eYSIP-2018/Low_Cost_Sensor_Node/FINAL_CODES/ATMEL_CODES/Readme.txt

Main final working codes are
1.RFreceiver
2.RFTRANS_1
In RFTRANS_1 just change the node number for increasing number of nodes
3.uartreceiver
Simple testing of  only uart
