eYSIP-2018/Low_Cost_Sensor_Node/FINAL_CODES/ARDUINO_CODES/Readme.txt

This folder contains all the testing codes on arduino-pro-mini.
