eYSIP-2018/Low_Cost_Sensor_Node/FINAL_CODES/ARDUINO_CODES/NRF24L01/Readme.txt

This file contains two code for basic testing of NRF24L01+ proper communication.
Also this Codes can be used for prototype tesing in outdoor enviornment.
