eYSIP-2018/Low_Cost_Sensor_Node/Documentation/Code Documentation/main.pdf

# NRF Based Sensor Node - Code Documentation

## Sachin Jadhav

## August 5, 2018

# 1 Introduction

### This Code Documenatation contains Documentation of three libraries

### 1. GPIO

### 2. SPI

3. RF24

# 2 Code Description

### - GPIO.cpp

### 1. void Set Pin (unsigned int num, unsigned int dir ) To set a particular pin as input (IN) or output (OUT) .e.g Set pin(13,OUT)

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

### 2. void Write Digital (unsigned char , unsigned char )

To set a particular output pin as a high or low by giving pin number and value. e.g. Write Digital(13,high);

1

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

### 3. void mosfet on() Turn on mosfet which is connected on D8 pin . Which gives supply voltage to NRF and ADC channels

void m o s f e t o n ( )
{
DDRB |= 0 x01 ; // m o s fe t D8 p in
PORTB |= 0 x00 ; // w r i t e 0 t o ON P c h annel MOSFET }

### 4. void mosfet off() Turn off mosfet which is connected on D8 pin . Which turn off the supply voltage to NRF and ADC channels

void m o s f e t o f f ( )
{

PORTB &= 0xFE ; // w r i t e 1 t o OFF P c h annel MOSFET }

### 5. void UART Init(); //initilzation of uart To initialize a UART for serial Communication with default 9600 baud rate

void UART Init ( )
{
UCSR0B = 0 x00 ;
UCSR0A = 0 x00 ;
UCSR0C|= (1<<UCSZ1) | (1<<UCSZ0)|(1<< USBS0 ) ;
// Asynchronous mode 8− b i t da ta and 1−s t o p b i t
// UBRR0L = 103 ;// 16MHZ f o r 9600 bps
UBRR0L = 5 1;
// 8MHZ C r y s t a l s e t baud r a t e 9 6 0 0 ( 5 1 ) , 4 8 0 0 ( 1 0 3 ) , 2 4 0 0 ( 2 0 6 )
fo r s e r i a l t r a n smi s si o n with e x t e r n a l c r y s t a l o s c i l a t o r a t 8. 0 MHz UBRR0H = 0 ;
UCSR0B |= (1<<RXEN) | (1<<TXEN) ; // Enable R e c e i p t i o n and Transm iss ion
}

2

6. char UART Read();

### This function checks for any data available on Rx bufer of Atmega328p And if availble

Reads 8 bit data in Rxbuffer and returns in char type data.

// //// t o read one b y t e
char UART Read ( )
{
while ( ! ( UCSR0A & (1<<RXC0 ) ) ) ; /∗ Wait u n t i l d a t a e x i s t s . ∗/ // l o o p u n t i l b i t i s s e t (UCSR0A, RXC0) ;
return UDR0;
}
7. void UART Transmit(unsigned char data );

### Transmitts single unsigned char data through UART

void UART Transmit (unsigned char data )
{
UCSR0A = 1<<TXC0;
/∗ Wait f o r empty t r a n sm i t b u f f e r ∗/
while ( ! ( UCSR0A & (1<<UDRE0) ) ) ;
/∗ Put da ta i n t o b u f f e r , sen d s t h e d a t a ∗/
UDR0 = data ;
while ( ! ( UCSR0A & (1<<TXC0 ) ) ) ; // w a i t f o r t a r n sm i s s i o n t o c om ple te }

### 8. void UART Printf(const char *text)

Sends String to serial i.e. to print a string on serial monitor without a newline character

void UART Printf ( const char ∗ t e x t )
{
unsigned char i =0;
while ( ! ( ∗ ( t e x t+i ) == ’ \0 ’ ) )
{
UART Transmit ( ∗ ( t e x t+i ) ) ; i ++;
}
}

### 9. void UART Printfln(const char *text) Sends String to serial i.e. to print a string on serial monitor with new line

void UART Printfln ( const char ∗ t e x t )
{
unsigned char i =0;
while ( ! ( ∗ ( t e x t+i ) == ’ \0 ’ ) )
{
UART Transmit ( ∗ ( t e x t+i ) ) ; i ++;
}
UART Transmit ( ’ \n ’ ) ;
}

### 10. void UART Print Num(unsigned int n) To print unsigned int number on serial monitor

/// t o p r i n t un s igne d i n t number
void UART Print Num (unsigned int n )
{
unsigned char ch=0;
ch= n/10000+0 x30 ;

3

i f ( ! ( ch==0x30 ) )
UART Transmit ( ch ) ;
n=n%10000;
ch=n/1000+0 x30 ;
i f ( ! ( ch==0x30 ) )
UART Transmit ( ch ) ;
n=n%1000;
ch=n/100+0 x30 ;
i f ( ! ( ch==0x30 ) )
UART Transmit ( ch ) ;
n=n%100;
ch=n/10+0x30 ;
i f ( ! ( ch==0x30 ) )
UART Transmit ( ch ) ;
ch=(n%10)+0x30 ;
UART Transmit ( ch ) ;
UART Transmit ( ’ \n ’ ) ;
}

### 11. void UART Print Numchar(unsigned char n) To print unsigned char number on serial monitor

/// t o p r i n t un s igne d char number
void UART Print Numchar (unsigned char n ) {
unsigned char ch=0;
ch=n/100+0 x30 ;
UART Transmit ( ch ) ;
n=n%100;
ch=n/10+0x30 ;
UART Transmit ( ch ) ;
ch=(n%10)+0x30 ;
UART Transmit ( ch ) ;
UART Transmit ( ’ \n ’ ) ; }
12. void timer0 init ();

### TIMER 0 is 8 bit timer Timer0 is used in CTC mode for delay function which creates delay of 1 millisecond using TIMERO ISR

// // t imer0 in CTC mode w i t h i n t e r r u p t
void t i m e r 0 i n i t ( )
{
// s e t t imer0 i n t e r r u p t a t 1kHz TCCR0A = 0 ;
TCCR0B = 0 ;
TCNT0 = 0 ;
// s e t compare match r e g i s t e r f o r 1 khz incremen t s
OCR0A = 1 2 4; // = (8∗10ˆ6) / (1000∗64) − 1 ( must be <256) // turn on CTC mode
TCCR0A |= ( 1 << WGM01) ;
// Se t CS01 and CS00 b i t s f o r 64 p r e s c a l e r
TCCR0B |= ( 1 << CS01 ) | ( 1 << CS00 ) ;
// e n a bl e t ime r compare i n t e r r u p t
TIMSK0 |= ( 1 << OCIE0A ) ;
}

### 13. ISR(TIMER0 COMPA vect)

4

### This is Interrupt Sub routine for TIMER 0 interrupt which updates global cnt variable

for getting current millis value in the running program.

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

### 14. unsigned int millis() This function gives current execution time of a program in millisecond

Returns a Integar variable in between 0 to 65535.

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

15. void power down (unsigned int s time) API function for setting u-controller in deep sleep mode for given time in minutes This function puts MCU in Power down mode i.e External Crystal is off , along with for reducing power consumption it Disables Brounout Detection , Disables digital input buffers on ADC pins The MCU is configured so as to wake up after predefined timeout using Watchdog timer . Which uses internal 128KHz crystal

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

5

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

### 16. ISR(WDT vect) This is Interrupt Subroutine for Watchdog timer which do nothing .Just used for Extend-

ing sleep timeout.

// ISR For WATCHDOG TIMER
ISR (WDT vect )
{

} ;

### 17. unsigned int adcinit(int channel) This function do the Initialization of ADC and returns ADC conversion result

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

### 18. uint8 t get batt voltage()

This Function reads the ADC channel number 5 .

### On channel number 5 battery voltage is connected . Returns the single byte result of

battery voltage.

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

### 19. uint8 t get temp(int ch) This Function reads the ADC channel number specified on which temperature sensor is

6

connected.

### Returns single byte result temperature value

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

### 20. uint8 t get soil moisture() This Function reads the ADC channel number 0 on which default soil moisture sensor is

connected.

### Returns single byte result of moisture content percentage value

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

### 21. void getdata()

Function to collect all sensors data for transmission.

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

### - SPI library This library has two files SPI.h and SPI.cpp

In SPI.h clas SPIClass is defined with its all methods.
In SPI.cpp it has API’s related initilsation of SPI for connected module.

### 1. SPI.h

7

#i fnd e f SPI H INCLUDED

#def ine | SPI H INCLUDED

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

8

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

### 2. SPI.cpp

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

SPCR |= BV (MSTR) ; // s e l e c t s mas ter mode
SPCR |= BV (SPE ) ; // En able s SPI communiation

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

### RF24 library contains 4 files

### – RF24config.h – nRF24L01.h – RF24.h – RF24.cpp

### (a) RF24config.h This file includes necessary header files for RF24.h and also defines some macros to

use in RF24.h file.

#i fnd e f | RF24 CONFIG H

#def ine | RF24 CONFIG H

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

#d e f i n e r f 2 4 mi n ( a , b ) ( a<b? a : b )

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

9

#e n d i f

#i n cl u d e ”SPI . h”

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

#i n cl u d e <s t d i o . h>

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

#d e f i n e BV ( x ) (1<<(x ) )

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

#d e f i n e p r i n t f P p r i n t f

#d e f i n e s t r l e n P s t r l e n

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

#d e f i n e PRIPSTR ”%s ”

#end if // RF24 CONFIG H

### (b) nRF24L01.h

This header file has declaration of macros for all registers in NRF24L01+ .

/∗ Memory Map ∗/
#def ine NRF CONFIG | 0 x00

#def ine EN AA | 0 x01

#def ine EN RXADDR | 0 x02

#def ine SETUP AW | 0 x03

#def ine SETUP RETR | 0 x04

#def ine RF CH | 0 x05

#def ine RF SETUP | 0 x06

#def ine NRF STATUS | 0 x07

#def ine OBSERVE TX | 0 x08

#def ine CD | 0 x09

#def ine RX ADDR P0 | 0x0A

#def ine RX ADDR P1 | 0x0B

#def ine RX ADDR P2 | 0x0C

#def ine RX ADDR P3 | 0x0D

#def ine RX ADDR P4 | 0x0E

#def ine RX ADDR P5 | 0x0F

#def ine TX ADDR | 0 x10

#def ine RX PW P0 | 0 x11

#def ine RX PW P1 | 0 x12

#def ine RX PW P2 | 0 x13

#def ine RX PW P3 | 0 x14

#def ine RX PW P4 | 0 x15

#def ine RX PW P5 | 0 x16

#def ine FIFO STATUS 0 x17

#def ine DYNPD | 0x1C

#def ine FEATURE | 0x1D

/∗ B i t Mnemonics ∗/
#def ine MASK RX DR | 6

#def ine MASK TX DS | 5

#def ine MASK MAX RT 4

#def ine EN CRC | 3

#def ine CRCO | 2

#def ine PWR UP | 1

#def ine PRIM RX | 0

#def ine ENAA P5 | 5

#def ine ENAA P4 | 4

10

#def ine ENAA P3 | 3

#def ine ENAA P2 | 2

#def ine ENAA P1 | 1

#def ine ENAA P0 | 0

#def ine ERX P5 | 5

#def ine ERX P4 | 4

#def ine ERX P3 | 3

#def ine ERX P2 | 2

#def ine ERX P1 | 1

#def ine ERX P0 | 0

#def ine AW | 0

#def ine ARD | 4

#def ine ARC | 0

#def ine PLL LOCK | 4

#def ine RF DR | 3

#def ine RF PWR | 6

#def ine RX DR | 6

#def ine TX DS | 5

#def ine MAX RT | 4

#def ine RX P NO | 1

#def ine TX FULL | 0

#def ine PLOS CNT | 4

#def ine ARC CNT | 0

#def ine TX REUSE | 6

#def ine FIFO FULL | 5

#def ine TX EMPTY | 4

#def ine RX FULL | 1

#def ine RX EMPTY | 0

#def ine DPL P5 | 5

#def ine DPL P4 | 4

#def ine DPL P3 | 3

#def ine DPL P2 | 2

#def ine DPL P1 | 1

#def ine DPL P0 | 0

#def ine EN DPL | 2

#def ine EN ACK PAY | 1

#def ine EN DYN ACK | 0

/∗ I n s t r u c t i o n Mnemonics ∗/
#def ine R REGISTER | 0 x00

#def ine W REGISTER | 0 x20

#def ine REGISTER MASK 0x1F

#def ine ACTIVATE | 0 x50

#def ine R RX PL WID | 0 x60

#def ine R RX PAYLOAD | 0 x61

#def ine W TX PAYLOAD | 0xA0

#def ine W ACK PAYLOAD 0xA8

#def ine FLUSH TX | 0xE1

#def ine FLUSH RX | 0xE2

#def ine REUSE TX PL | 0xE3

#def ine NOP | 0xFF

/∗ Non−P om i s s i on s ∗/
#def ine LNA HCURR 0

/∗ P model memory Map ∗/
#def ine RPD | 0 x09

#def ine W TX PAYLOAD NO ACK | 0xB0

/∗ P model b i t Mnemonics ∗/

11

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

#def ine RF DR HIGH | 3

#def ine RF PWR LOW | 1 // f o r s e t t i n g n r f in power down

#def ine RF PWR HIGH 2 // f o r power ing up t h e NRF24L01+ module

### (c) RF24.h In this library a class RF24 is written with declaration of public ,protected ,private

data members and methods.

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

#include ”nRF24L01 . h”

#include ” RF24con fig . h”

#i fnd e f | RF24 H

#def ine | RF24 H

/∗ ∗
∗ @ f i l e RF24 . h
∗
∗ Cl a s s d e c l a r a t i o n f o r RF24 and h e l p e r enums ∗/
/∗ ∗
∗ Power Am pl i f i e r l e v e l .
∗
∗ For use w i t h se tPALevel ( )
∗/
typedef enum { RF24 PA MIN = 0 ,RF24 PA LOW, RF24 PA HIGH , RF24 PA MAX, RF24 PA ERROR } r f 2 4 p a d bm e ;

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

/∗ ∗
∗ CRC Leng th . How b i g ( i f any ) o f a CRC i s i n cl u d e d .
∗
∗ For use w i t h setCRCLength ( )
∗/
typedef enum { RF24 CRC DISABLED = 0 , RF24 CRC 8 , RF24 CRC 16 } r f 2 4 c r c l e n g t h e ;

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

12

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

// Ends SPI t r a n s a c t i o n by making CSN low
in l in e void endT r an s ac ti on ( ) ;

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

13

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

14

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

void openW ri tingPipe ( const u i n t 8 t ∗ a d d r e s s ) ;

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

15

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

void openReadingPipe ( u i n t 8 t number , const u i n t 8 t ∗ a d d r e s s ) ;

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

16

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

17

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

18

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

/∗ ∗

19

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

20

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

21

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

/∗ ∗@} ∗/

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

void setAddressWidth ( u i n t 8 t a wid th ) ;

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

/∗ ∗
∗ Se t RF communication c h annel
∗
∗ @param c h annel Which RF c h annel t o communicate on , 0−125 ∗/
void se tCh annel ( u i n t 8 t ch annel ) ;

/∗ ∗
∗ Get RF communication c h annel ∗

22

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

23

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

24 void setAutoAck ( u i n t 8 t pipe , bool e n a bl e ) ;

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

/∗ ∗
∗ D i s a bl e CRC v a l i d a t i o n

25

∗
∗ @warning CRC canno t be d i s a b l e d i f auto−ack /ESB i s e n a bl e d . ∗/
void disableCRC ( void ) ;

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

u i n t 3 2 t txDelay ;

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

u i n t 3 2 t c sDel a y ;

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

26

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

private :

/∗ ∗

27

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

/∗ ∗
∗ Read t h e r e c e i v e p a yl o a d

28

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

u i n t 8 t s piT r a n s ( u i n t 8 t cmd ) ;

#i f d e fi n e d (FAILURE HANDLING) | | d e fi n e d (RF24 LINUX )

void e r r N o t i f y ( void ) ;
#e n d i f

} ; // end o f RF24 Cl a s s

#end if // RF24 H

### (d) RF24.cpp

In this file defination of all methods of RF24 object are written in C++.

29
