eYSIP-2018/Low_Cost_Sensor_Node/Documentation/Progress_Presentation_1/main.pdf

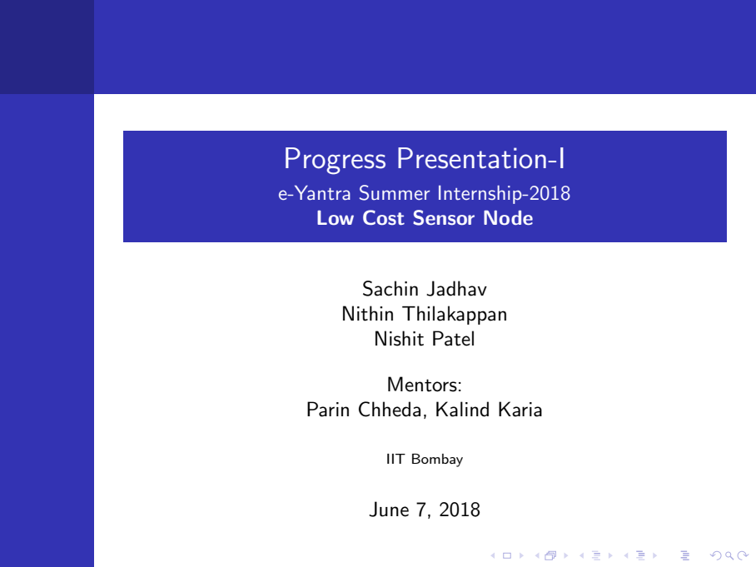
[picture p20: figure]
Progress Presentation-I; e-Yantra Summer Internship-2018 Low Cost Sensor Node; Sachin Jadhav Nithin Thilakappan Nishit Patel; Mentors: Parin Chheda, Kalind Karia; IIT Bombay; June 7, 2018

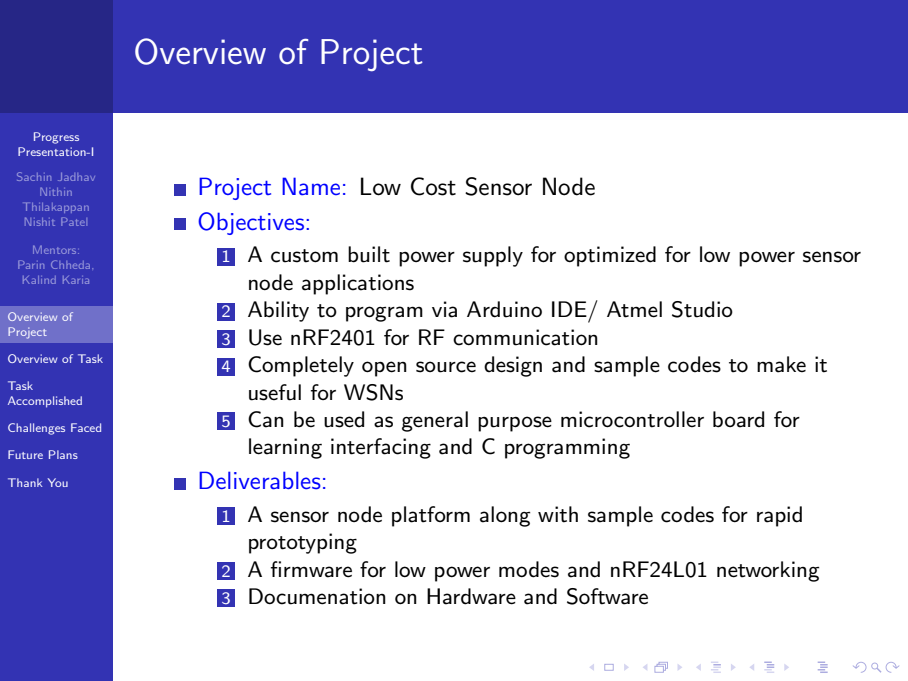
[picture p21: figure]
Progress Presentation-I; Sachin Jadhav Nithin Thilakappan Nishit Patel; Mentors: Parin Chheda, Kalind Karia; Overview of Project; Overview of Task; Task Accomplished; Challenges Faced; Future Plans; Thank You; Project Name: Low Cost Sensor Node; Objectives:; node applications; Use nRF2401 for RF communication; useful for WSNs; learning interfacing and C programming Deliverables:; prototyping; Documenation on Hardware and Software

1 | A custom built power supply for optimized for low power sensor
2 | Ability to program via Arduino IDE/ Atmel Studio
4 | Completely open source design and sample codes to make it
5 | Can be used as general purpose microcontroller board for
1 | A sensor node platform along with sample codes for rapid
2 | A firmware for low power modes and nRF24L01 networking

Progress
Presentation-I

Sachin Jadhav
Nithin
Thilakappan
Nishit Patel

Mentors:
Parin Chheda,
Kalind Karia

Overview of
Project

Overview of Task

Task
Accomplished

Challenges Faced

Future Plans

Thank You

# Overview of Task

Task No. | Tasks | Deadline (in Days)
1 | Study about different sensor nodes platform available and their USP. Take desirable aspects of each | 1
2 | Review low power modes in ATmega328p, nRF2401 litera-ture review | 1
3 | Build prototype using Arduino Pro Mini and nRF2401, test range theoretically and experimentally in outdoor environ-ment | 2
4 | Research components available and select to fit price v/s performance metric | 2
5 | Build PCB design, source components, evaluation in Proteus (if necessary) | 5
6 | Prototype soldering and testing | 2
7 | Building a network of 3 nodes, relaying info, power consump-tion analysis | 5
8 | Making reusable firmware for nRF2401, interfacing soil mois-ture, temperature/humidity sensors | 4-5
9 | Loading TinyOS, initial experiments | 2
10 | Trying out the features available in tiny OS, feasibility check | 3
11 | Firmware documentation, hardware manual and reporting result | 3

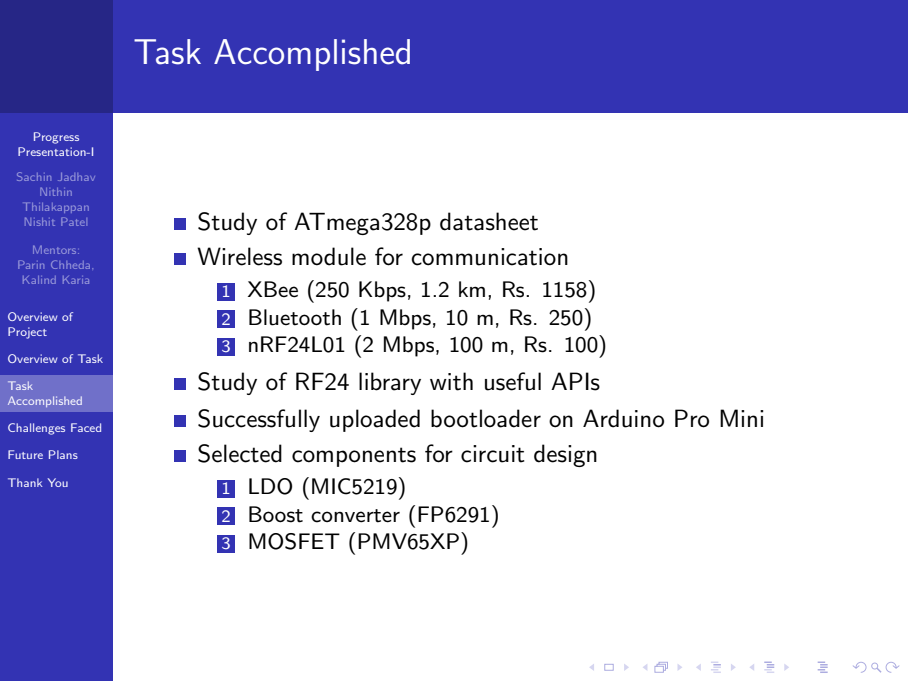
[picture p22: figure]
Progress Presentation-I; Sachin Jadhav Nithin Thilakappan Nishit Patel; Mentors: Parin Chheda, Kalind Karia; Overview of Project; Overview of Task; Task Accomplished; Challenges Faced; Future Plans; Thank You; Study of ATmega328p datasheet; Wireless module for communication; XBee (250 Kbps, 1.2 km, Rs. 1158); Bluetooth (1 Mbps, 10 m, Rs. 250); nRF24L01 (2 Mbps, 100 m, Rs. 100); Study of RF24 library with useful APIs; Selected components for circuit design; LDO (MIC5219); Boost converter (FP6291); MOSFET (PMV65XP)

# Successfully uploaded bootloader on Arduino Pro Mini

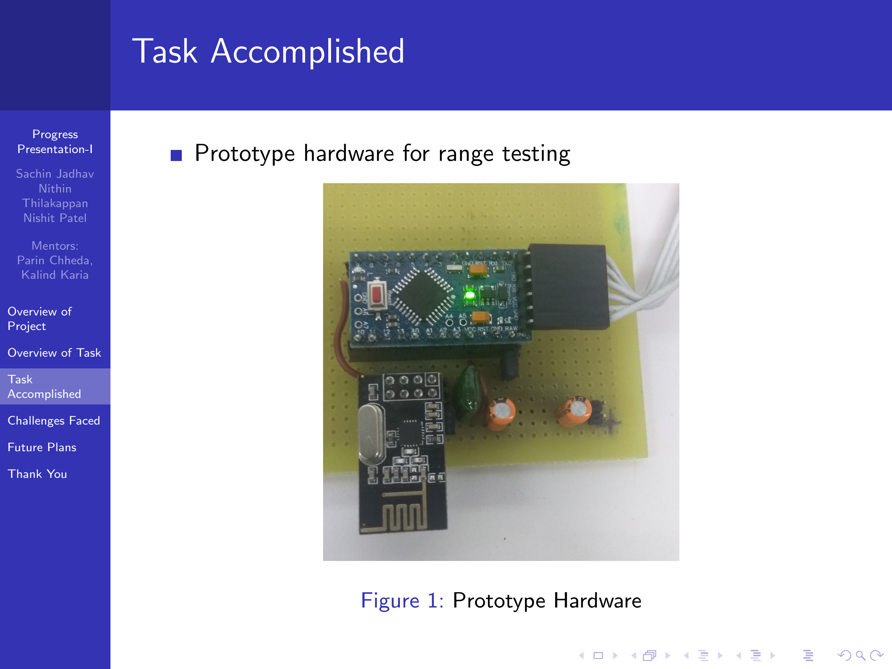
[picture p23: figure]
Progress Presentation-I; Sachin Jadhav Nithin Thilakappan Nishit Patel; Mentors: Parin Chheda, Kalind Karia; Overview of Project; Overview of Task; Task Accomplished; Challenges Faced; Future Plans; Thank You; Prototype hardware for range testing; Figure 1: Prototype Hardware

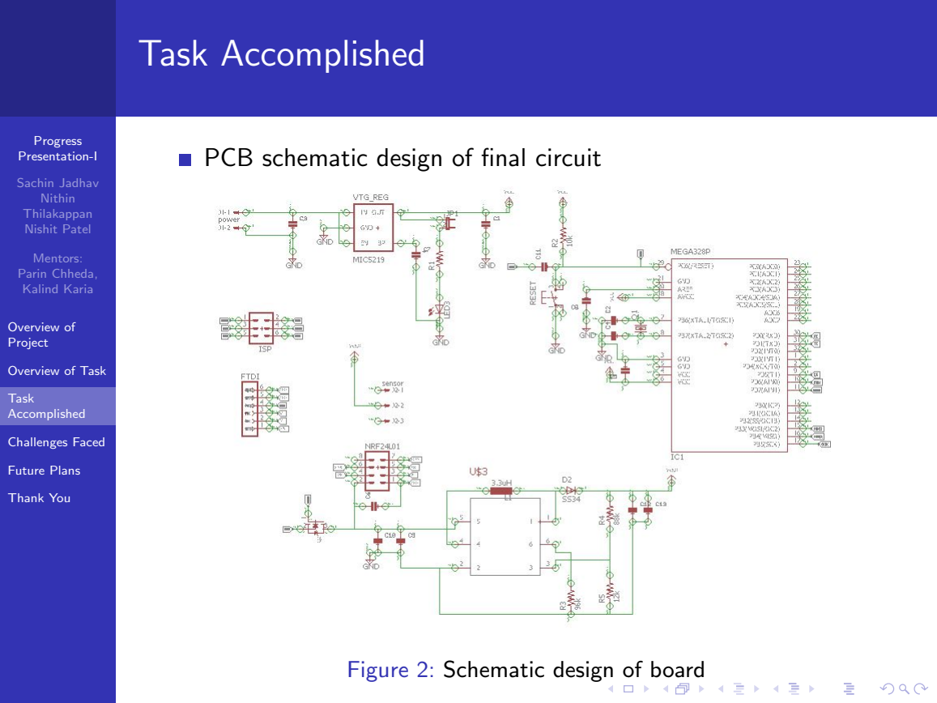
[picture p24: figure]
Progress Presentation-I; Sachin Jadhav Nithin Thilakappan Nishit Patel; Mentors: Parin Chheda, Kalind Karia; Overview of Project; Overview of Task; Task Accomplished; Challenges Faced; Future Plans; Thank You; PCB schematic design of final circuit; Figure 2: Schematic design of board

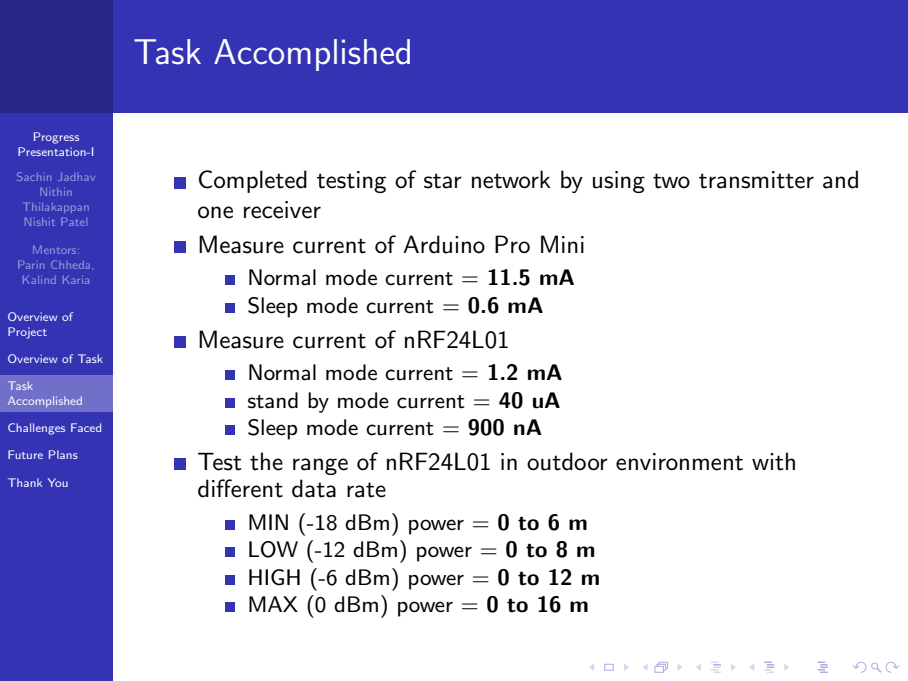
[picture p25: figure]
Progress Presentation-I; Sachin Jadhav Nithin Thilakappan Nishit Patel; Mentors: Parin Chheda, Kalind Karia; Overview of Project; Overview of Task; Task Accomplished; Challenges Faced; Future Plans; Thank You; one receiver; Measure current of Arduino Pro Mini; Normal mode current = 11.5 mA Sleep mode current = 0.6 mA Measure current of nRF24L01; Normal mode current = 1.2 mA stand by mode current = 40 uA Sleep mode current = 900 nA; different data rate; MIN (-18 dBm) power = 0 to 6 m LOW (-12 dBm) power = 0 to 8 m HIGH (-6 dBm) power = 0 to 12 m MAX (0 dBm) power = 0 to 16 m

# Completed testing of star network by using two transmitter and

# Test the range of nRF24L01 in outdoor environment with

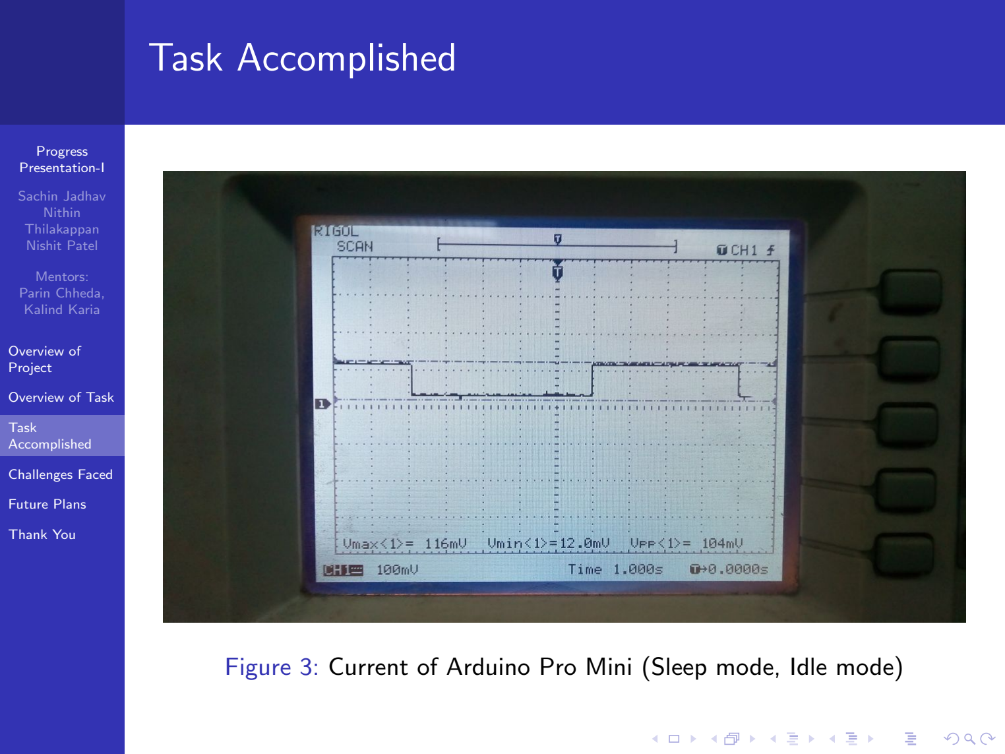
[picture p26: figure]
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

# Figure 3: Current of Arduino Pro Mini (Sleep mode, Idle mode)

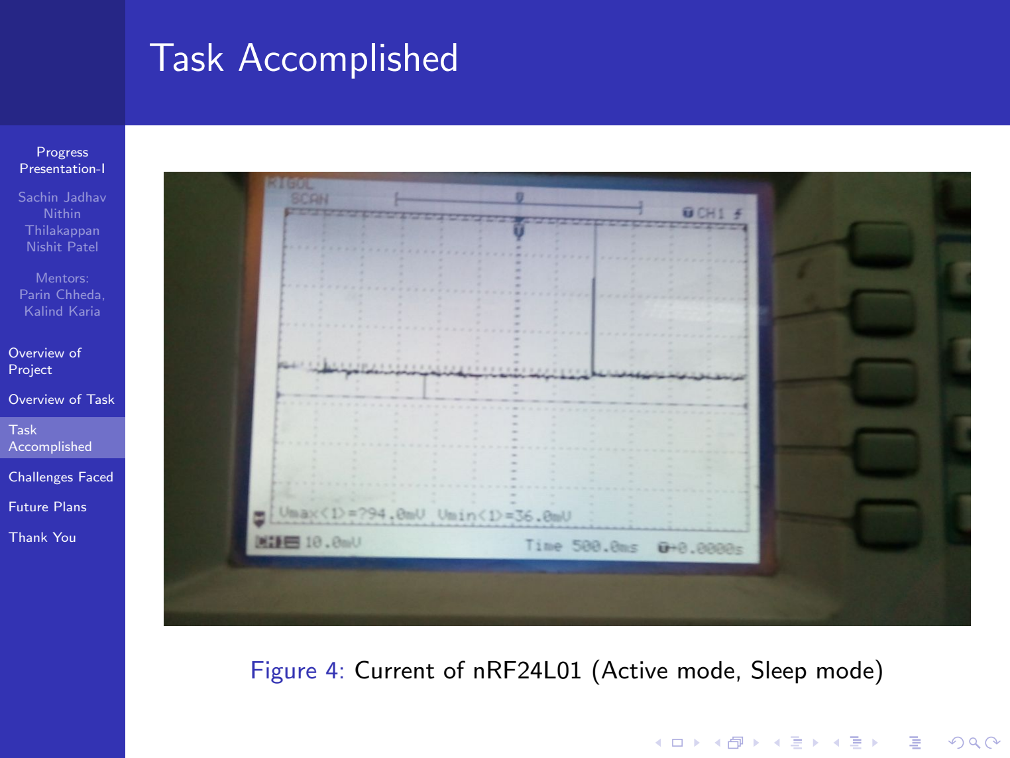
[picture p27: figure]
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

# Figure 4: Current of nRF24L01 (Active mode, Sleep mode)

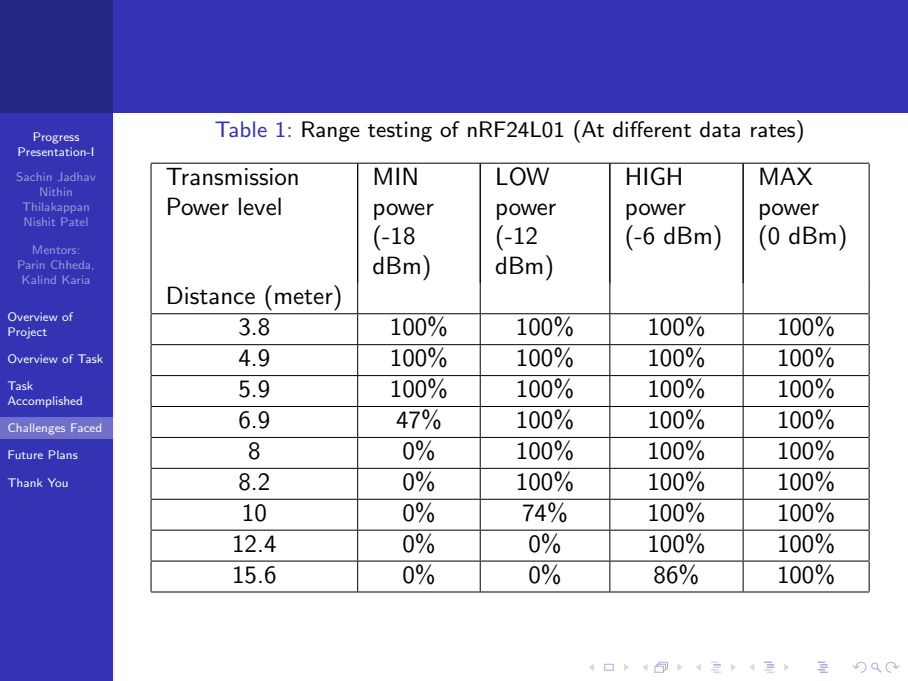
[picture p28: figure]
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

# Table 1: Range testing of nRF24L01 (At different data rates)

Transmission Power level Distance (meter) | MIN power (-18 dBm) | LOW power (-12 dBm) | HIGH power (-6 dBm) | MAX power (0 dBm)

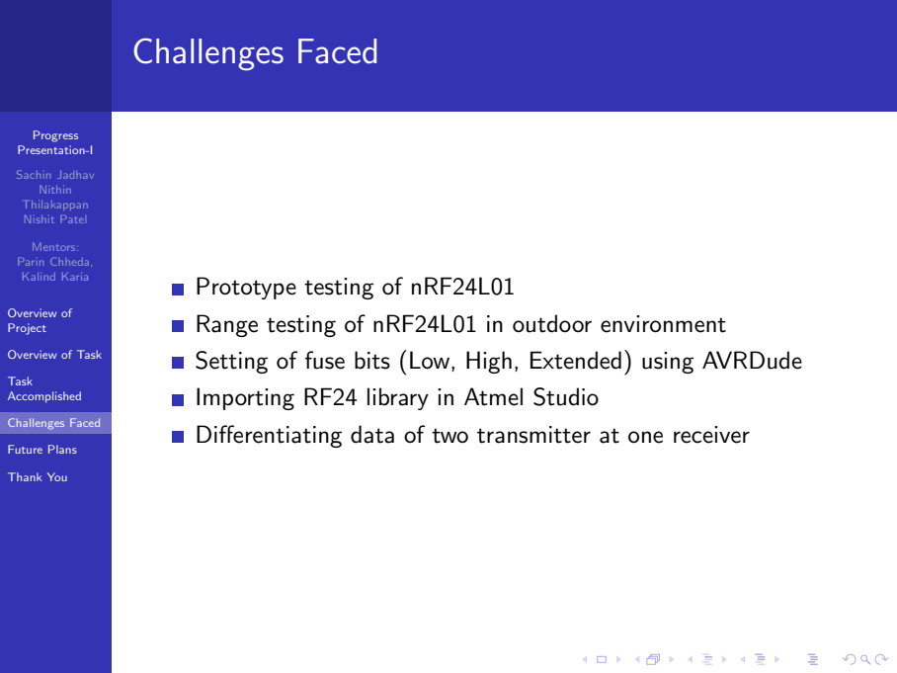
[picture p29: figure]
Progress Presentation-I; Sachin Jadhav Nithin Thilakappan Nishit Patel; Mentors: Parin Chheda, Kalind Karia; Overview of Project; Overview of Task; Task Accomplished; Challenges Faced; Future Plans; Thank You; Prototype testing of nRF24L01; Importing RF24 library in Atmel Studio

# Range testing of nRF24L01 in outdoor environment

# Setting of fuse bits (Low, High, Extended) using AVRDude

# Differentiating data of two transmitter at one receiver

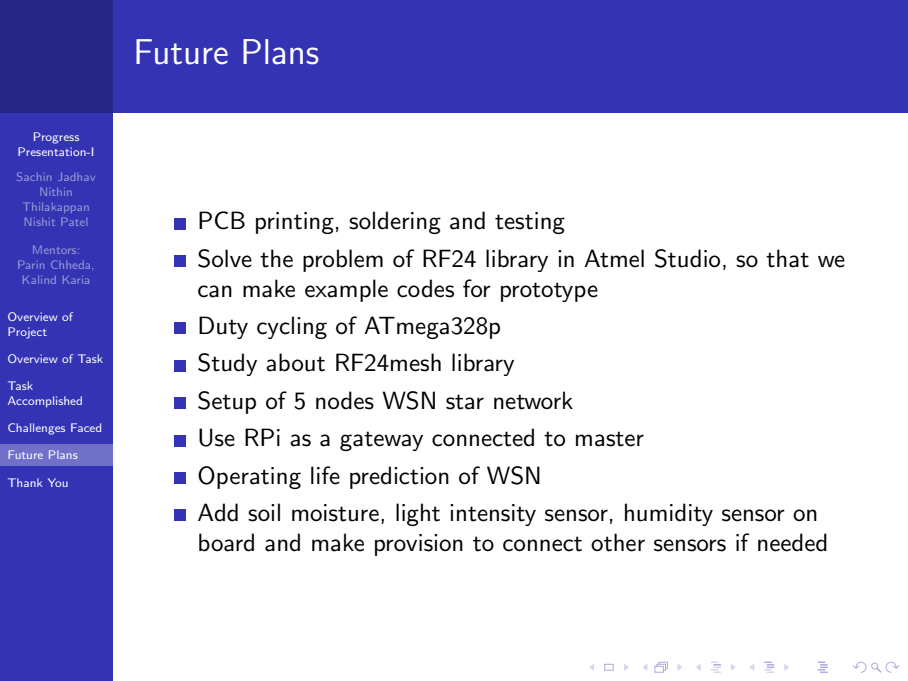
[picture p30: figure]
Progress Presentation-I; Sachin Jadhav Nithin Thilakappan Nishit Patel; Mentors: Parin Chheda, Kalind Karia; Overview of Project; Overview of Task; Task Accomplished; Challenges Faced; Future Plans; Thank You; PCB printing, soldering and testing; can make example codes for prototype; Duty cycling of ATmega328p; Study about RF24mesh library; Setup of 5 nodes WSN star network; Operating life prediction of WSN

# Solve the problem of RF24 library in Atmel Studio, so that we

# Use RPi as a gateway connected to master

# Add soil moisture, light intensity sensor, humidity sensor on board and make provision to connect other sensors if needed

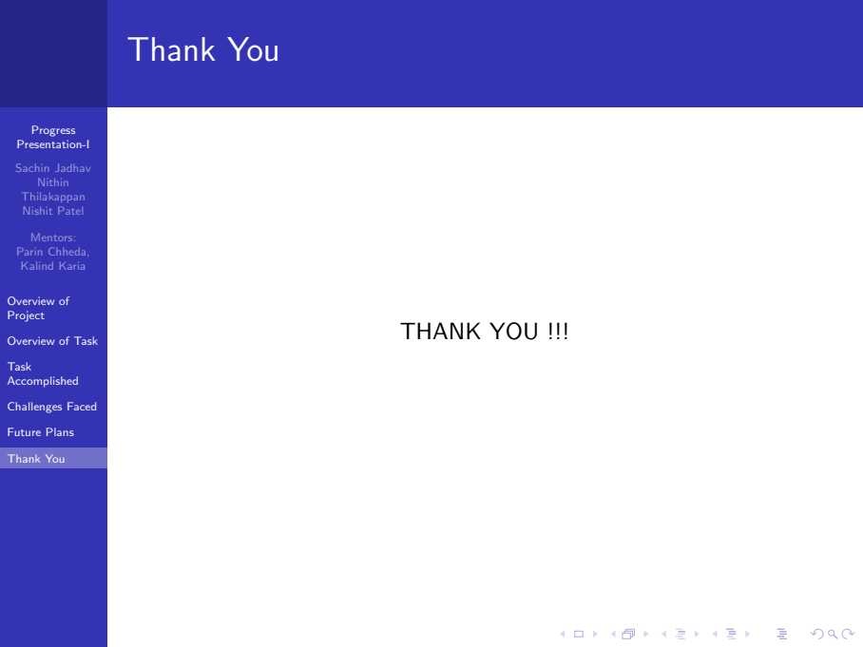
[picture p31: figure]
Progress Presentation-I; Sachin Jadhav Nithin Thilakappan Nishit Patel; Mentors: Parin Chheda, Kalind Karia; Overview of Project; Overview of Task; Task Accomplished; Challenges Faced; Future Plans; Thank You; THANK YOU !!!
