eYSIP-2018/Low_Cost_Sensor_Node/Documentation/Progress_Presentation_2/main.pdf

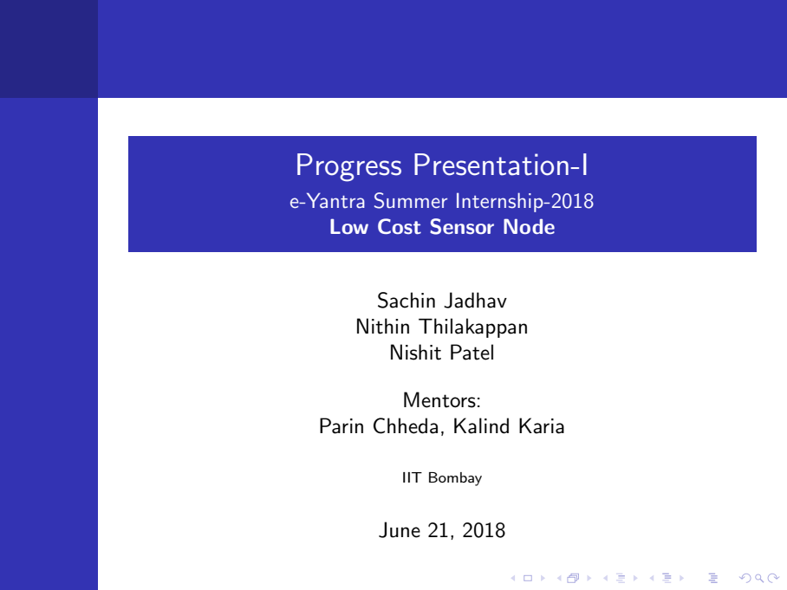
[picture p32: figure]
Progress Presentation-I; e-Yantra Summer Internship-2018 Low Cost Sensor Node; Sachin Jadhav Nithin Thilakappan Nishit Patel; Mentors: Parin Chheda, Kalind Karia; IIT Bombay; June 21, 2018

Progress Presentation-I; Sachin Jadhav Nithin Thilakappan Nishit Patel; Mentors: Parin Chheda, Kalind Karia; Overview of Project; Overview of Task; Task Accomplished; Challenges Faced; Future Plans; Thank You; Project Name: Low Cost Sensor Node; Objectives:; node applications; Use nRF2401 for RF communication; useful for WSNs; learning interfacing and C programming Deliverables:; prototyping; Documenation on Hardware and Software

1 | A custom built power supply for optimized for low power sensor
2 | Ability to program via Arduino IDE/ Atmel Studio
4 | Completely open source design and sample codes to make it
5 | Can be used as general purpose microcontroller board for
1 | A sensor node platform along with sample codes for rapid
2 | A firmware for low power modes and nRF24L01 networking

Progress
Presentation-I

Sachin Jadhav
Nithin
Thilakappan
Nishit Patel

Mentors:
Parin Chheda,
Kalind Karia

Overview of
Project

Overview of Task

Task
Accomplished

Challenges Faced

Future Plans

Thank You

# Overview of Task

Task No. | Tasks | Completion
1 | Study about different sensor nodes platform available and their USP. Take desirable aspects of each | Completed
2 | Review low power modes in ATmega328p, nRF2401 litera-ture review | Completed
3 | Build prototype using Arduino Pro Mini and nRF2401, test range theoretically and experimentally in outdoor environ-ment | Completed
4 | Research components available and select to fit price v/s performance metric | Completed
5 | Build PCB design, source components, evaluation in Proteus (if necessary) | Completed
6 | Prototype soldering and testing | Pending
7 | Building a network of 3 nodes, relaying info, power consump-tion analysis | Working on
8 | Making reusable firmware for nRF2401, interfacing soil mois-ture, temperature/humidity sensors | Working on
9 | Gateway implementation using ESP32 | Completed
10 | Firmware documentation, hardware manual and reporting result | 3

!

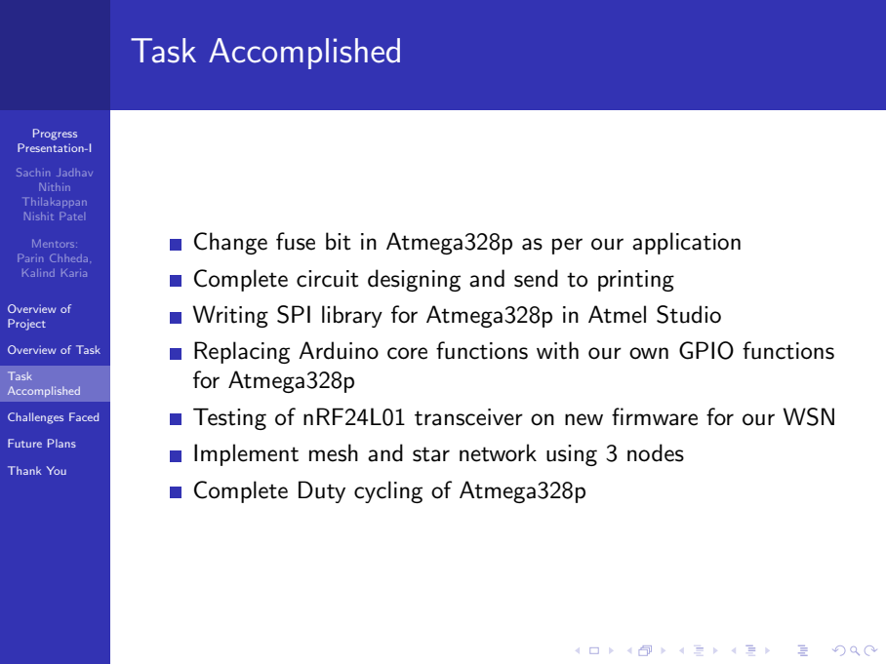
[picture p33: figure]
Progress Presentation-I; Sachin Jadhav Nithin Thilakappan Nishit Patel; Mentors: Parin Chheda, Kalind Karia; Overview of Project; Overview of Task; Task Accomplished; Challenges Faced; Future Plans; Thank You; for Atmega328p; Complete Duty cycling of Atmega328p

# Change fuse bit in Atmega328p as per our application

# Complete circuit designing and send to printing

# Writing SPI library for Atmega328p in Atmel Studio

# Replacing Arduino core functions with our own GPIO functions

# Testing of nRF24L01 transceiver on new firmware for our WSN

# Implement mesh and star network using 3 nodes

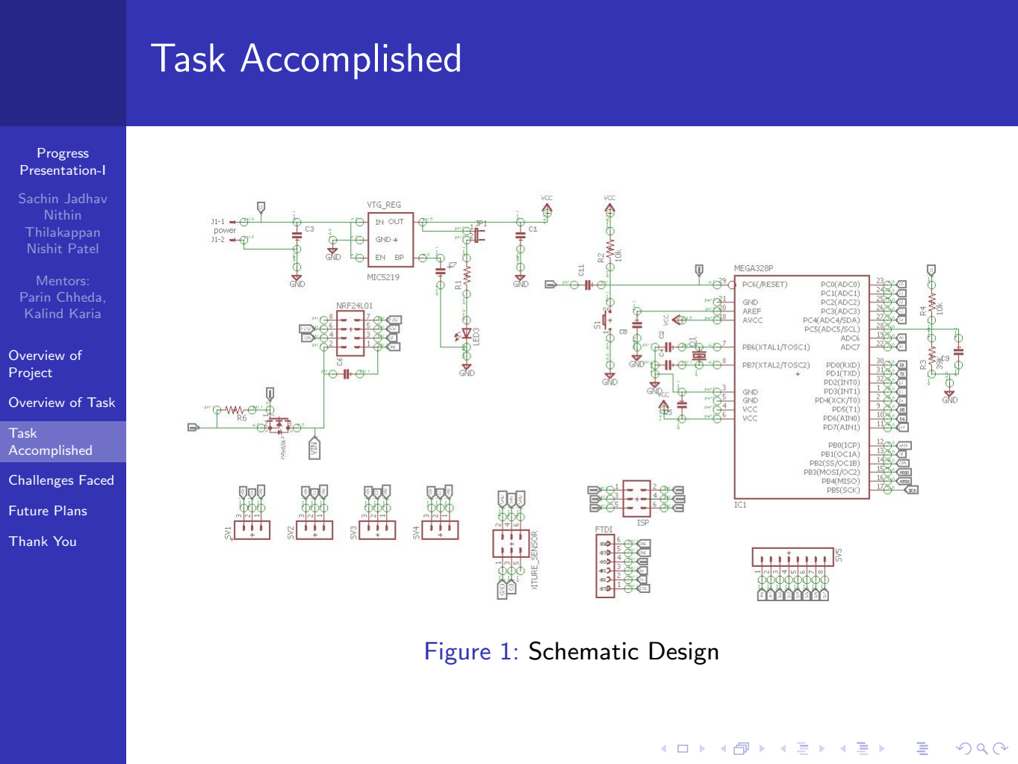
[picture p34: figure]
Progress Presentation-I; Sachin Jadhav Nithin Thilakappan Nishit Patel; Mentors: Parin Chheda, Kalind Karia; Overview of Project; Overview of Task; Task Accomplished; Challenges Faced; Future Plans; Thank You; Figure 1: Schematic Design

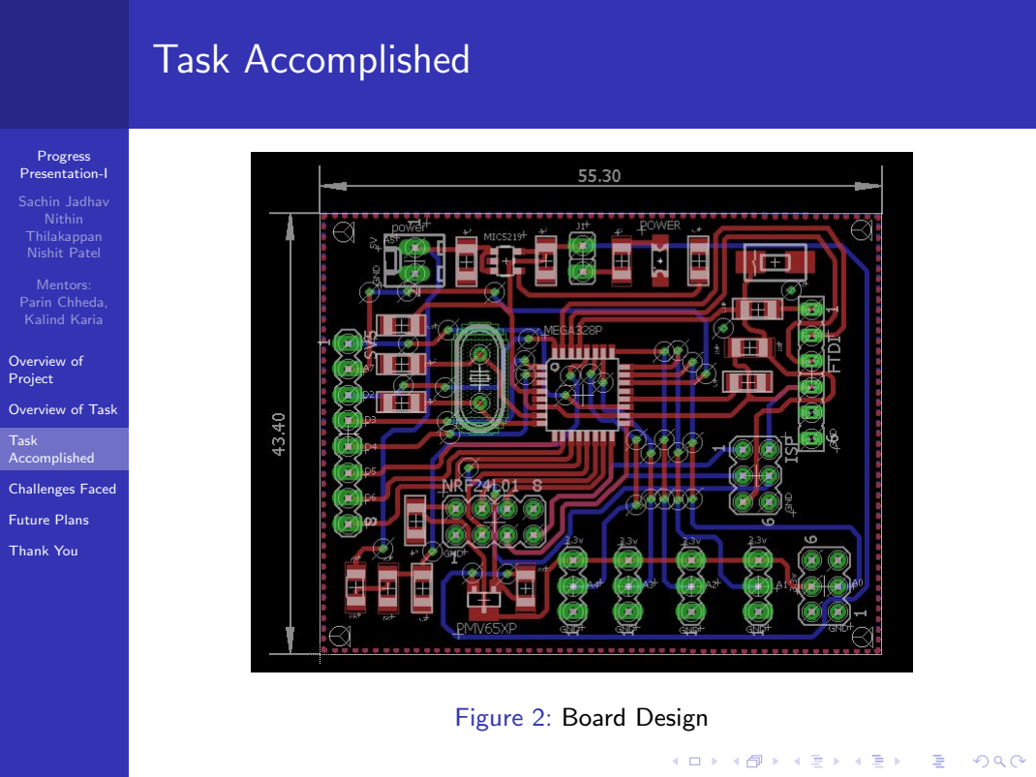
[picture p35: figure]
Progress Presentation-I; Sachin Jadhav Nithin Thilakappan Nishit Patel; Mentors: Parin Chheda, Kalind Karia; Overview of Project; Overview of Task; Task Accomplished; Challenges Faced; Future Plans; Thank You; Figure 2: Board Design

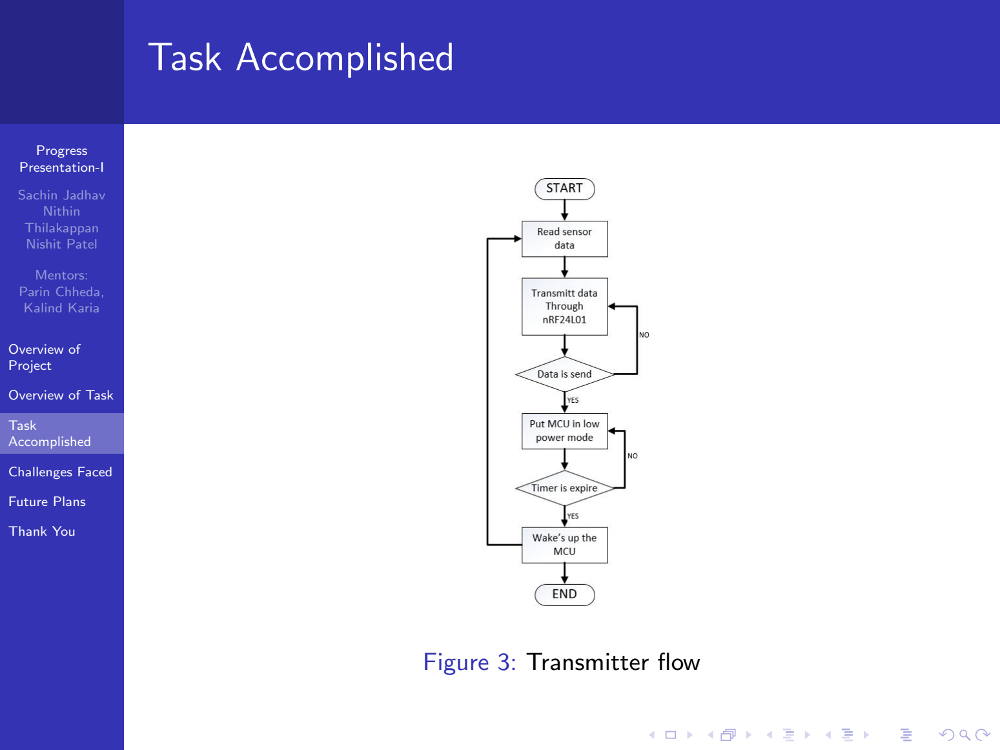
[picture p36: figure]
Progress Presentation-I; Sachin Jadhav Nithin Thilakappan Nishit Patel; Mentors: Parin Chheda, Kalind Karia; Overview of Project; Overview of Task; Task Accomplished; Challenges Faced; Future Plans; Thank You; Figure 3: Transmitter flow

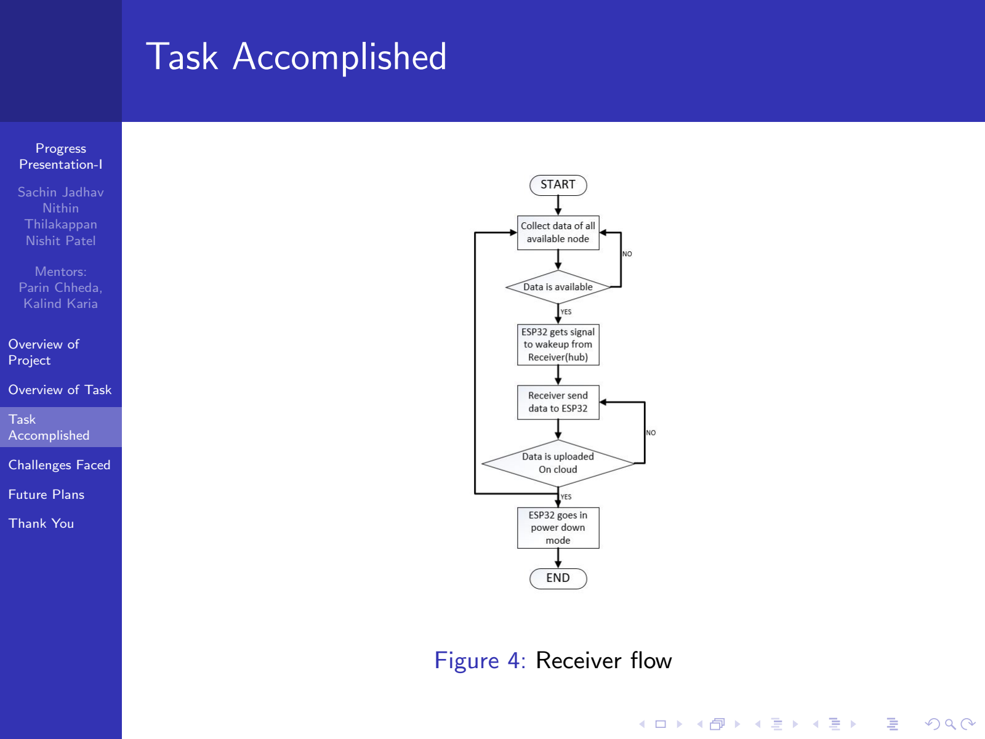
[picture p37: figure]
Progress Presentation-I; Sachin Jadhav Nithin Thilakappan Nishit Patel; Mentors: Parin Chheda, Kalind Karia; Overview of Project; Overview of Task; Task Accomplished; Challenges Faced; Future Plans; Thank You; Figure 4: Receiver flow

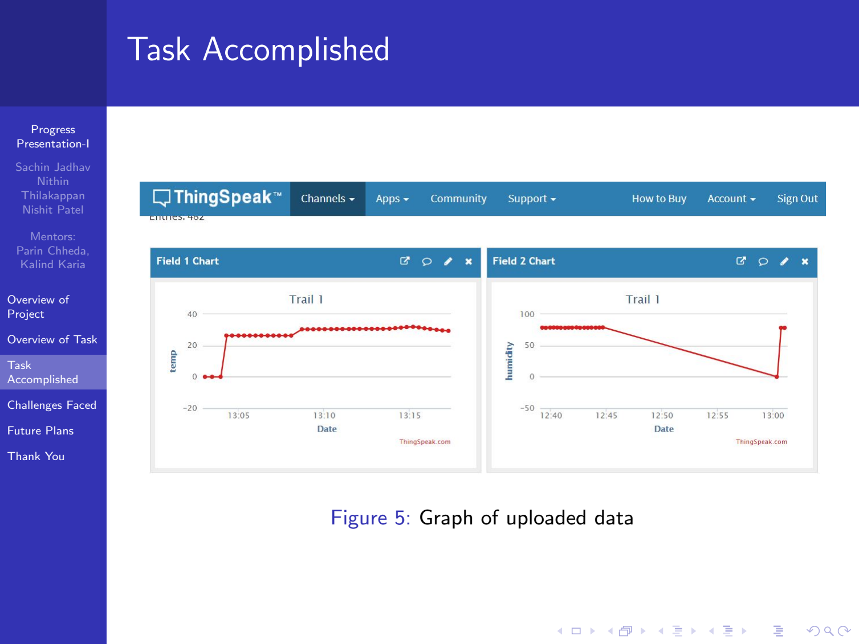
[picture p38: figure]
Progress Presentation-I; Sachin Jadhav Nithin Thilakappan Nishit Patel; Mentors: Parin Chheda, Kalind Karia; Overview of Project; Overview of Task; Task Accomplished; Challenges Faced; Future Plans; Thank You; Figure 5: Graph of uploaded data

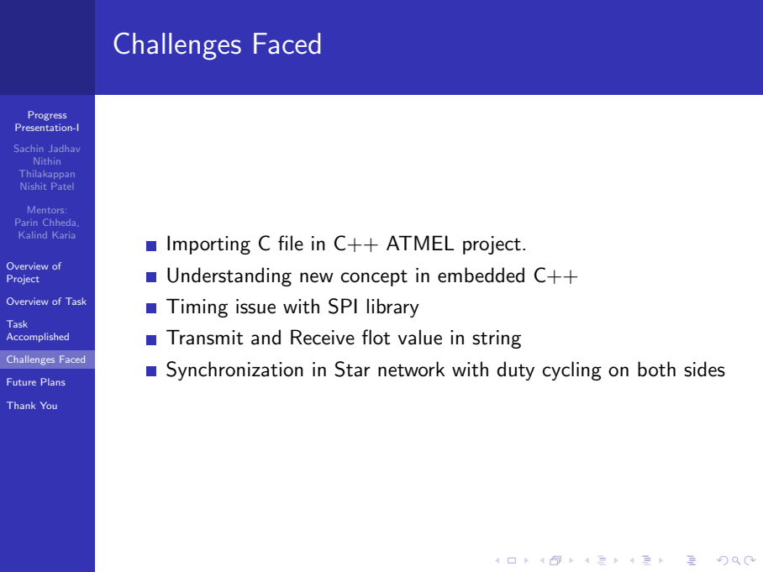
[picture p39: figure]
Progress Presentation-I; Sachin Jadhav Nithin Thilakappan Nishit Patel; Mentors: Parin Chheda, Kalind Karia; Overview of Project; Overview of Task; Task Accomplished; Challenges Faced; Future Plans; Thank You; Importing C file in C++ ATMEL project.; Timing issue with SPI library

# Understanding new concept in embedded C++

# Transmit and Receive flot value in string

# Synchronization in Star network with duty cycling on both sides

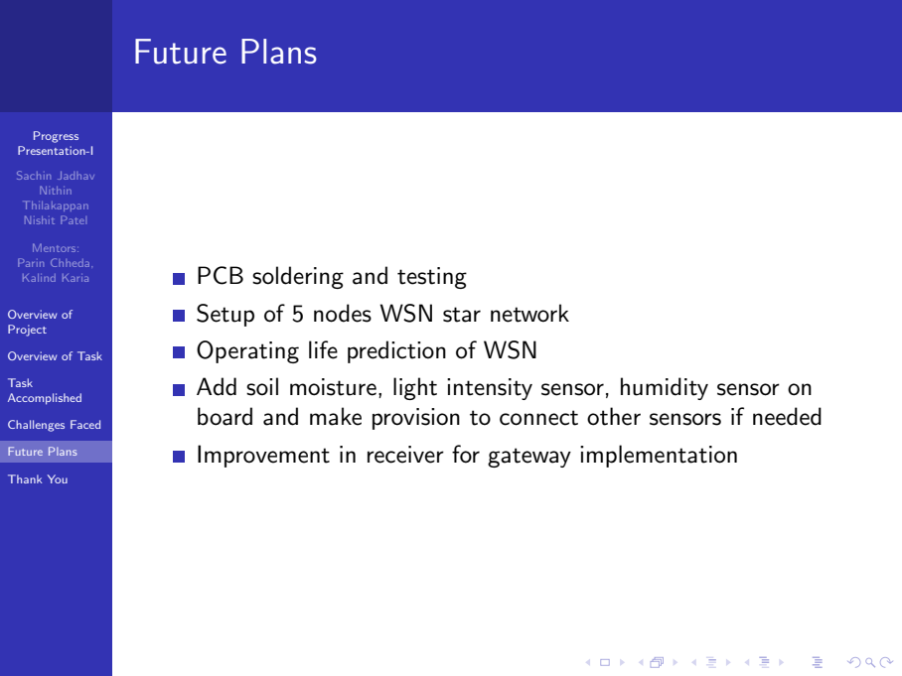
[picture p40: figure]
Progress Presentation-I; Sachin Jadhav Nithin Thilakappan Nishit Patel; Mentors: Parin Chheda, Kalind Karia; Overview of Project; Overview of Task; Task Accomplished; Challenges Faced; Future Plans; Thank You; PCB soldering and testing; Setup of 5 nodes WSN star network; Operating life prediction of WSN

# Add soil moisture, light intensity sensor, humidity sensor on board and make provision to connect other sensors if needed

# Improvement in receiver for gateway implementation

Progress Presentation-I; Sachin Jadhav Nithin Thilakappan Nishit Patel; Mentors: Parin Chheda, Kalind Karia; Overview of Project; Overview of Task; Task Accomplished; Challenges Faced; Future Plans; Thank You; THANK YOU !!!
