eYSIP-2018/Low_Cost_Sensor_Node/Schematic_PCB_Files/final_board.brd

## EAGLE design Schematic_PCB_Files/final_board.brd (2018-07-01)

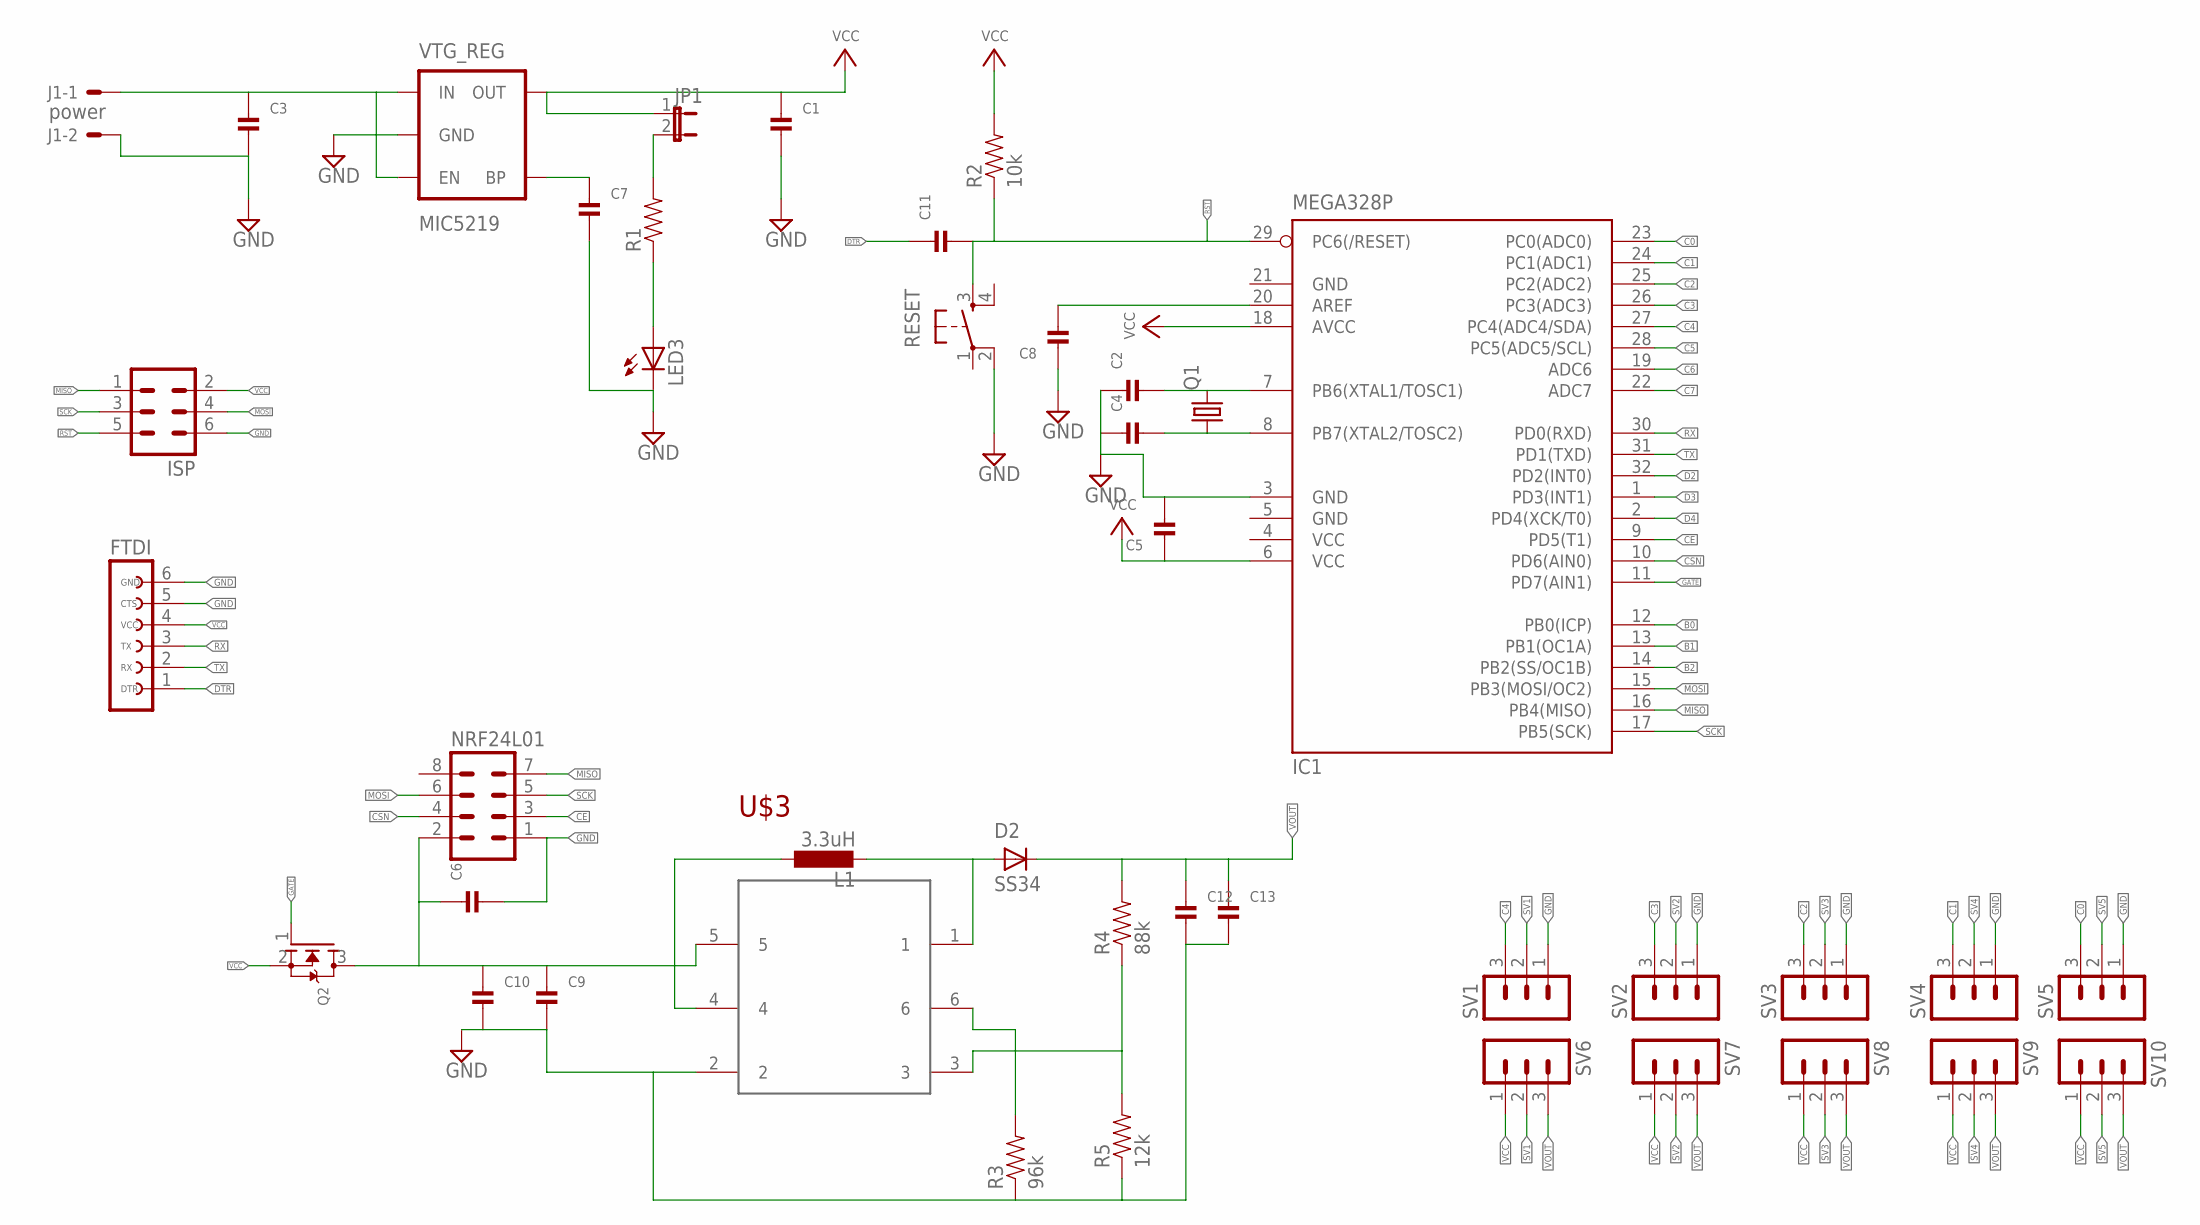
[picture p41: schematic final_board.sch]

Parts:
C1, C2, C3, C4, C5, C6, C7, C8, C9, C10, C11, C12, C13: CAP_CERAMIC1206; 1206
D2: SS34; SMA-DO214AC
FTDI: FE06-1; FE06
IC1: MEGA328P; TQFP32-08
ISP: MA03-2
J1: power; 6410-02
JP1: JP1E; JP1
L1: 3.3uH; L4532M
LED3: LEDSML1206; SML1206
NRF24L01: MA04-2
Q1: CRYSTALHC49U-V; HC49U-V
Q2: MOSFET-NWAVE; SOT23-W
R1: RESISTOR1206; 1206
R2: 10k; 1206
R3: 96k; 1206
R4: 88k; 1206
R5: 12k; 1206
RESET: TAC_SWITCHSMD; TACTILE_SWITCH_SMD
SV1, SV2, SV3, SV4, SV5, SV6, SV7, SV8, SV9, SV10: MA03-1
U$3: FP6291SOT23-6L; SOT23-6L
VTG_REG: MIC5219; SOT23-5

Connections:
2: C6.1, C9.1, C10.1, NRF24L01.2, Q2.3 (D), U$3.5
5V: C3.1, J1.1, VTG_REG.1 (IN), VTG_REG.3 (EN)
AREF: C8.2, IC1.20 (AREF)
B0: IC1.12 (PB0(ICP))
B1: IC1.13 (PB1(OC1A))
B2: IC1.14 (PB2(SS/OC1B))
C0: IC1.23 (PC0(ADC0)), SV5.3
C1: IC1.24 (PC1(ADC1)), SV4.3
C2: IC1.25 (PC2(ADC2)), SV3.3
C3: IC1.26 (PC3(ADC3)), SV2.3
C4: IC1.27 (PC4(ADC4/SDA)), SV1.3
C5: IC1.28 (PC5(ADC5/SCL))
C6: IC1.19 (ADC6)
C7: IC1.22 (ADC7)
CE: IC1.9 (PD5(T1)), NRF24L01.3
CSN: IC1.10 (PD6(AIN0)), NRF24L01.4
D2: IC1.32 (PD2(INT0))
D3: IC1.1 (PD3(INT1))
D4: IC1.2 (PD4(XCK/T0))
DTR: C11.1, FTDI.1
GATE: IC1.11 (PD7(AIN1)), Q2.1 (G)
GND: C1.2, C2.1, C3.2, C4.1, C5.2, C6.2, C7.2, C8.1, C9.2, C10.2, C12.2, C13.2, FTDI.5, FTDI.6, IC1.3 (GND), IC1.5 (GND), IC1.21 (GND), ISP.6, J1.2, LED3.C, NRF24L01.1, R3.1, R5.1, RESET.2, SV1.1, SV2.1, SV3.1, SV4.1, SV5.1, U$3.2, VTG_REG.2 (GND)
MISO: IC1.16 (PB4(MISO)), ISP.1, NRF24L01.7
MOSI: IC1.15 (PB3(MOSI/OC2)), ISP.4, NRF24L01.6
unnamed: C2.2, IC1.7 (PB6(XTAL1/TOSC1)), Q1.2
unnamed: C4.2, IC1.8 (PB7(XTAL2/TOSC2)), Q1.1
unnamed: JP1.2, R1.2
unnamed: LED3.A, R1.1
unnamed: C7.1, VTG_REG.4 (BP)
unnamed: L1.1, U$3.4
unnamed: R3.2, U$3.6
unnamed: D2.A, L1.2, U$3.1
unnamed: R4.1, R5.2, U$3.3
RST: C11.2, IC1.29 (PC6(/RESET)), ISP.5, R2.1, RESET.3
RX: FTDI.3, IC1.30 (PD0(RXD))
SCK: IC1.17 (PB5(SCK)), ISP.3, NRF24L01.5
SV1: SV1.2, SV6.2
SV2: SV2.2, SV7.2
SV3: SV3.2, SV8.2
SV4: SV4.2, SV9.2
SV5: SV5.2, SV10.2
TX: FTDI.2, IC1.31 (PD1(TXD))
VCC: C1.1, C5.1, FTDI.4, IC1.4 (VCC), IC1.6 (VCC), IC1.18 (AVCC), ISP.2, JP1.1, Q2.2 (S), R2.2, SV6.1, SV7.1, SV8.1, SV9.1, SV10.1, VTG_REG.5 (OUT)
VOUT: C12.1, C13.1, D2.K (C), R4.2, SV6.3, SV7.3, SV8.3, SV9.3, SV10.3

Notes on the sheet:
GND
CTS
VCC
DTR

Board: 2 copper layers, 42 parts (0 on the bottom side), 35 nets, no tracks yet.
