eYSIP-2018/Low_Cost_Sensor_Node/FINAL_CODES/NITHIN/Byte_end_reciever_jun29a/Byte_end_reciever_jun29a.ino

#include <RF24_config.h>
#include <RF24.h>
#include <printf.h>
#include <nRF24L01.h>

#include <SPI.h>

byte data[4] = "";
byte data1[4] = "";
RF24 radio(9, 10);
const uint64_t pipes[6] = {0xF0F0F0F0E1LL,0xF0F0F0F0E2LL, 0xF0F0F0F0E3LL};

void setup(void)
 {
   
   Serial.begin(9600);
   radio.begin();
   radio.setDataRate(RF24_250KBPS);
   radio.openReadingPipe(0, pipes[0]);
   radio.startListening(); // node will work as a simple_receiver node
     
 }
void loop(void)
 {
   while (radio.available())
   {
    radio.read(data, sizeof(data));
    radio.read(data1, sizeof(data1));
    Serial.println(data[3]);    
    Serial.println(data1[2]);
   } 
 
   delay(100);
 }
