eYSIP-2018/Low_Cost_Sensor_Node/(commit log)

2018-05-24 arduino code for low power mode
2018-06-04 started writing uart code in the same file
2018-06-05 UART in Embedded with 9600 baud written
2018-06-07 Final pcb design
    [final_board.sch]
2018-06-07 timero and UART ,LED BLINK in EMBEDDED
2018-06-07 UART and blink issue solved
    [timer0_delay.ino]
2018-06-11 delay using timer0 in embedded C
2018-06-13 RF receiver code SPI library modified in atmel
2018-06-15 RF24 project in Atmel with own SPI library
2018-06-21 tx and rx with dutycyling in power down and data diffrentiation
2018-06-21 new function for printing byte added
2018-06-27 Serial communication between atmegand esp32
2018-06-29 proper handshakimg with esp32 along with 4 node data
2018-07-01 ESP Final working
    [final_board.brd]
2018-07-23 folder for all SCHEMATIC FILES
    [final_board.brd, final_board.sch, untitled.brd]
2018-07-25 Repo cleaned made diffrent folders
    [final_board.brd, final_board.sch, untitled.brd]
